elixpo/flappy6502/programmer/README.md

Copied from ~/elixpo_projects/Nano28C64 (MIT, see LICENSE): host CLI (eeprom28c64/),
Arduino firmware (firmware/) and breadboard wiring. Local change: added the `flash`
command (program + verify, then reconnect and verify again). Use ../flash to run it.
