elixpo/flappy6502/GOVERNANCE.md

# Governance

The lead maintainer is @Circuit-Overtime. Material scope, release, governance, and lifecycle changes require maintainer review.

Contributors retain attribution for accepted work. Repository transfer, licensing, security disclosure, publication, and project-status decisions require explicit human approval. Canonical public status is recorded at [elixpo.com](https://elixpo.com).
