elixpo/flappy6502/docs/screenshot.png

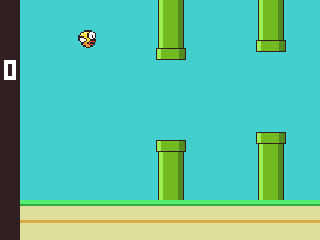
docs/screenshot.png
