elixpo/flappy6502/hardware/flappy6502_schematic.pdf

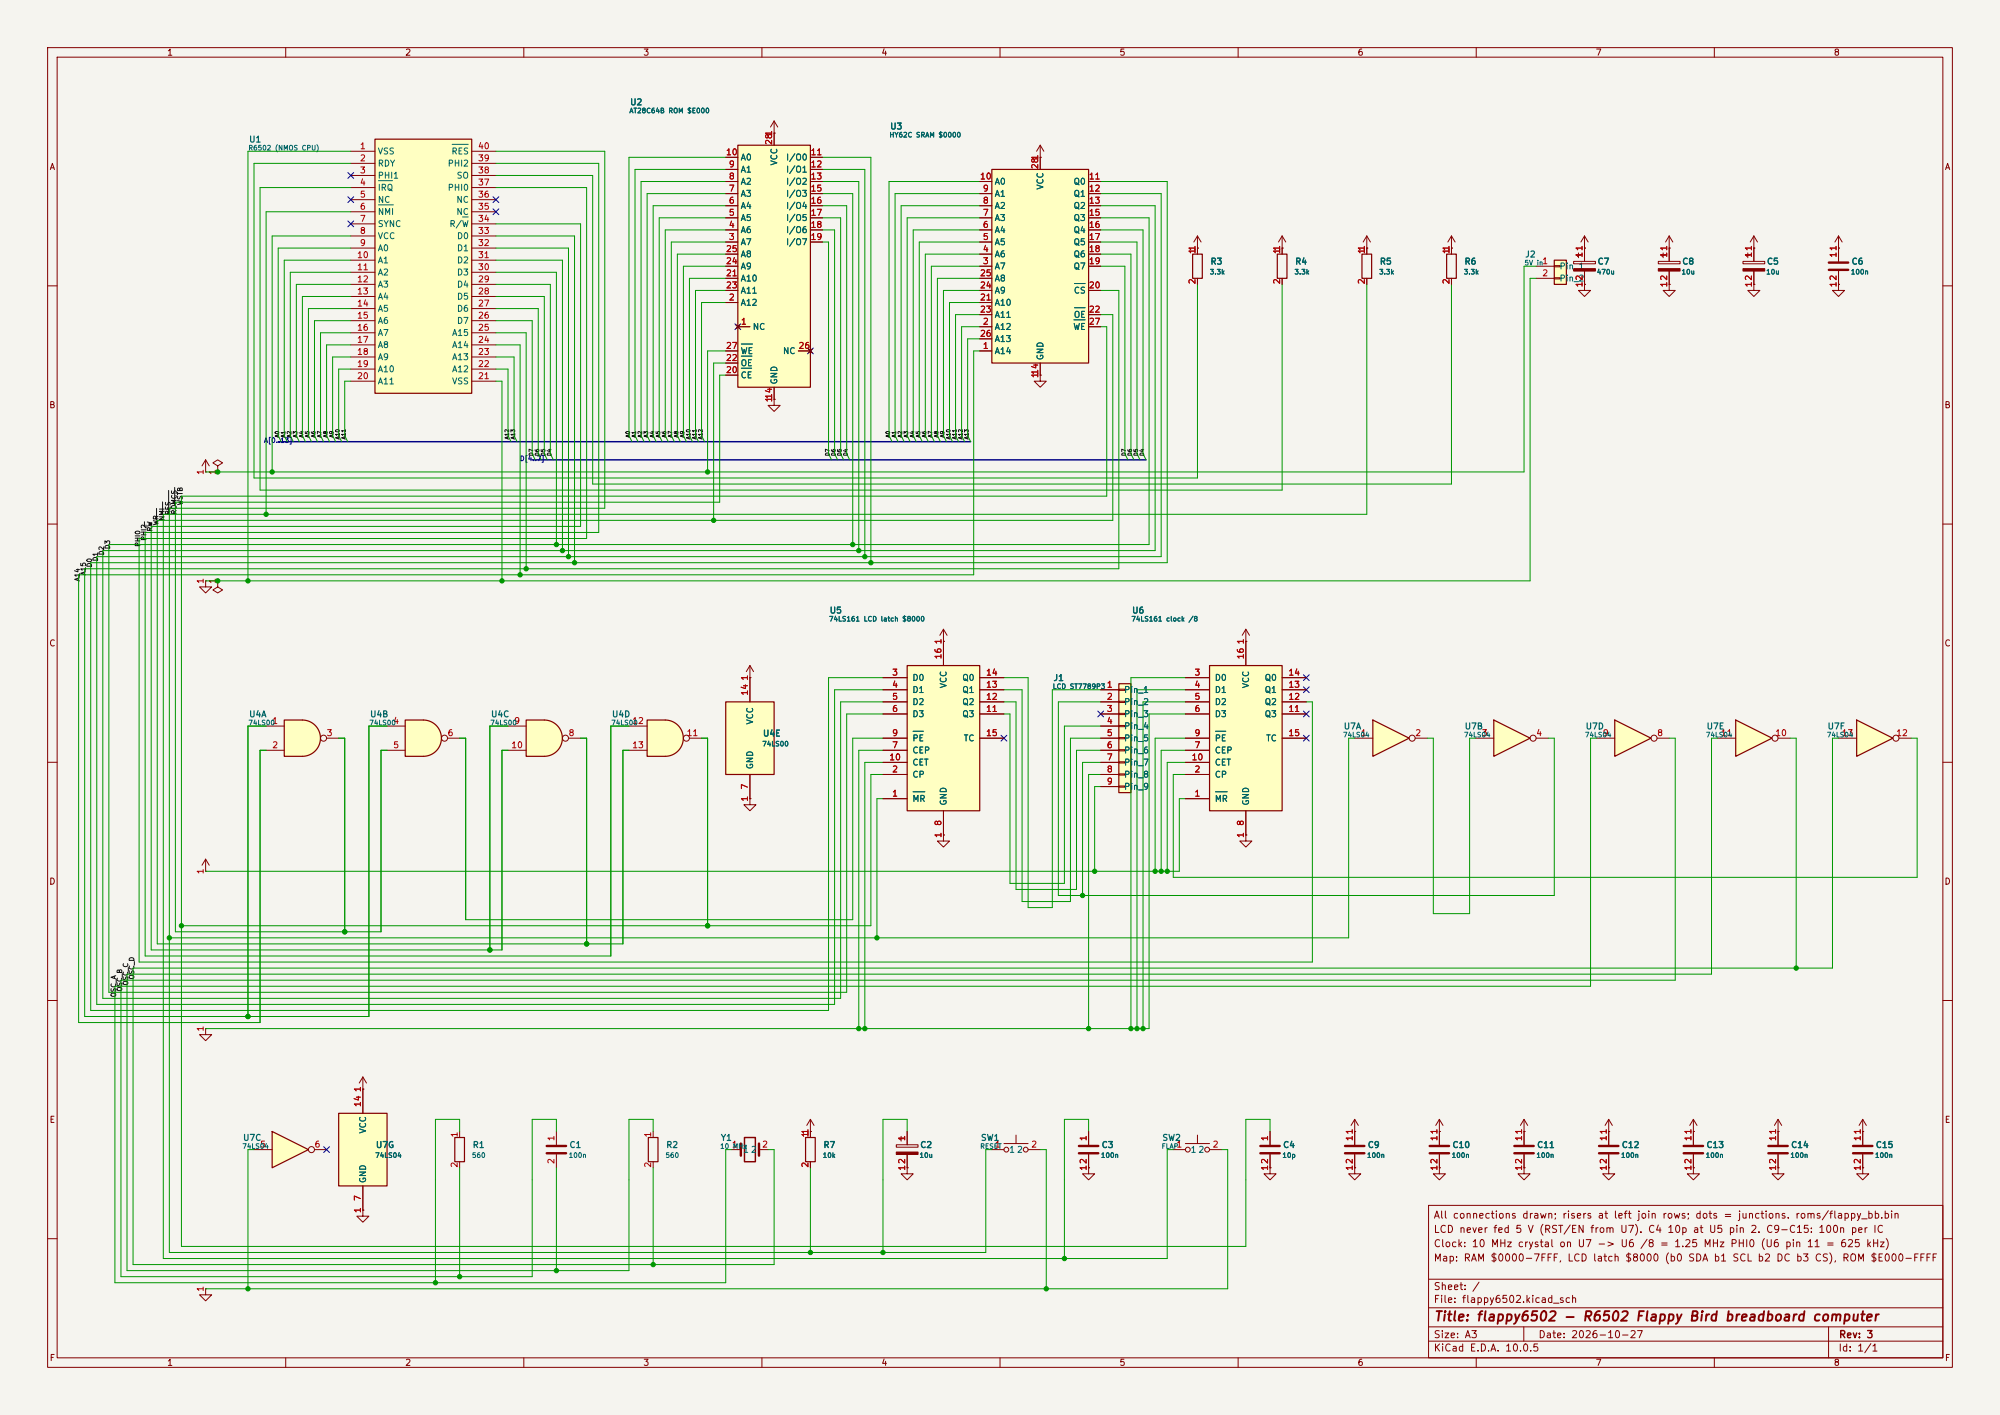
[picture p3: page 1]

All connections drawn; risers at left join rows; dots = junctions. roms/flappy_bb.bin
LCD never fed 5 V (RST/EN from U7). C4 10p at U5 pin 2. C9-C15: 100n per IC
Clock: 10 MHz crystal on U7 -> U6 /8 = 1.25 MHz PHI0 (U6 pin 11 = 625 kHz)
Map: RAM $0000-7FFF, LCD latch $8000 (b0 SDA b1 SCL b2 DC b3 CS), ROM $E000-FFFF

Sheet: /
File: flappy6502.kicad_sch
Title: flappy6502 - R6502 Flappy Bird breadboard computer

Size: A3 | Rev: 3 | F Date: 2026-10-27
KiCad E.D.A. 10.0.5 | Id: 1/1
