elixpo/flappy6502/hardware/flappy6502.kicad_sch

## KiCad design hardware/flappy6502.kicad_sch (2026-10-27)

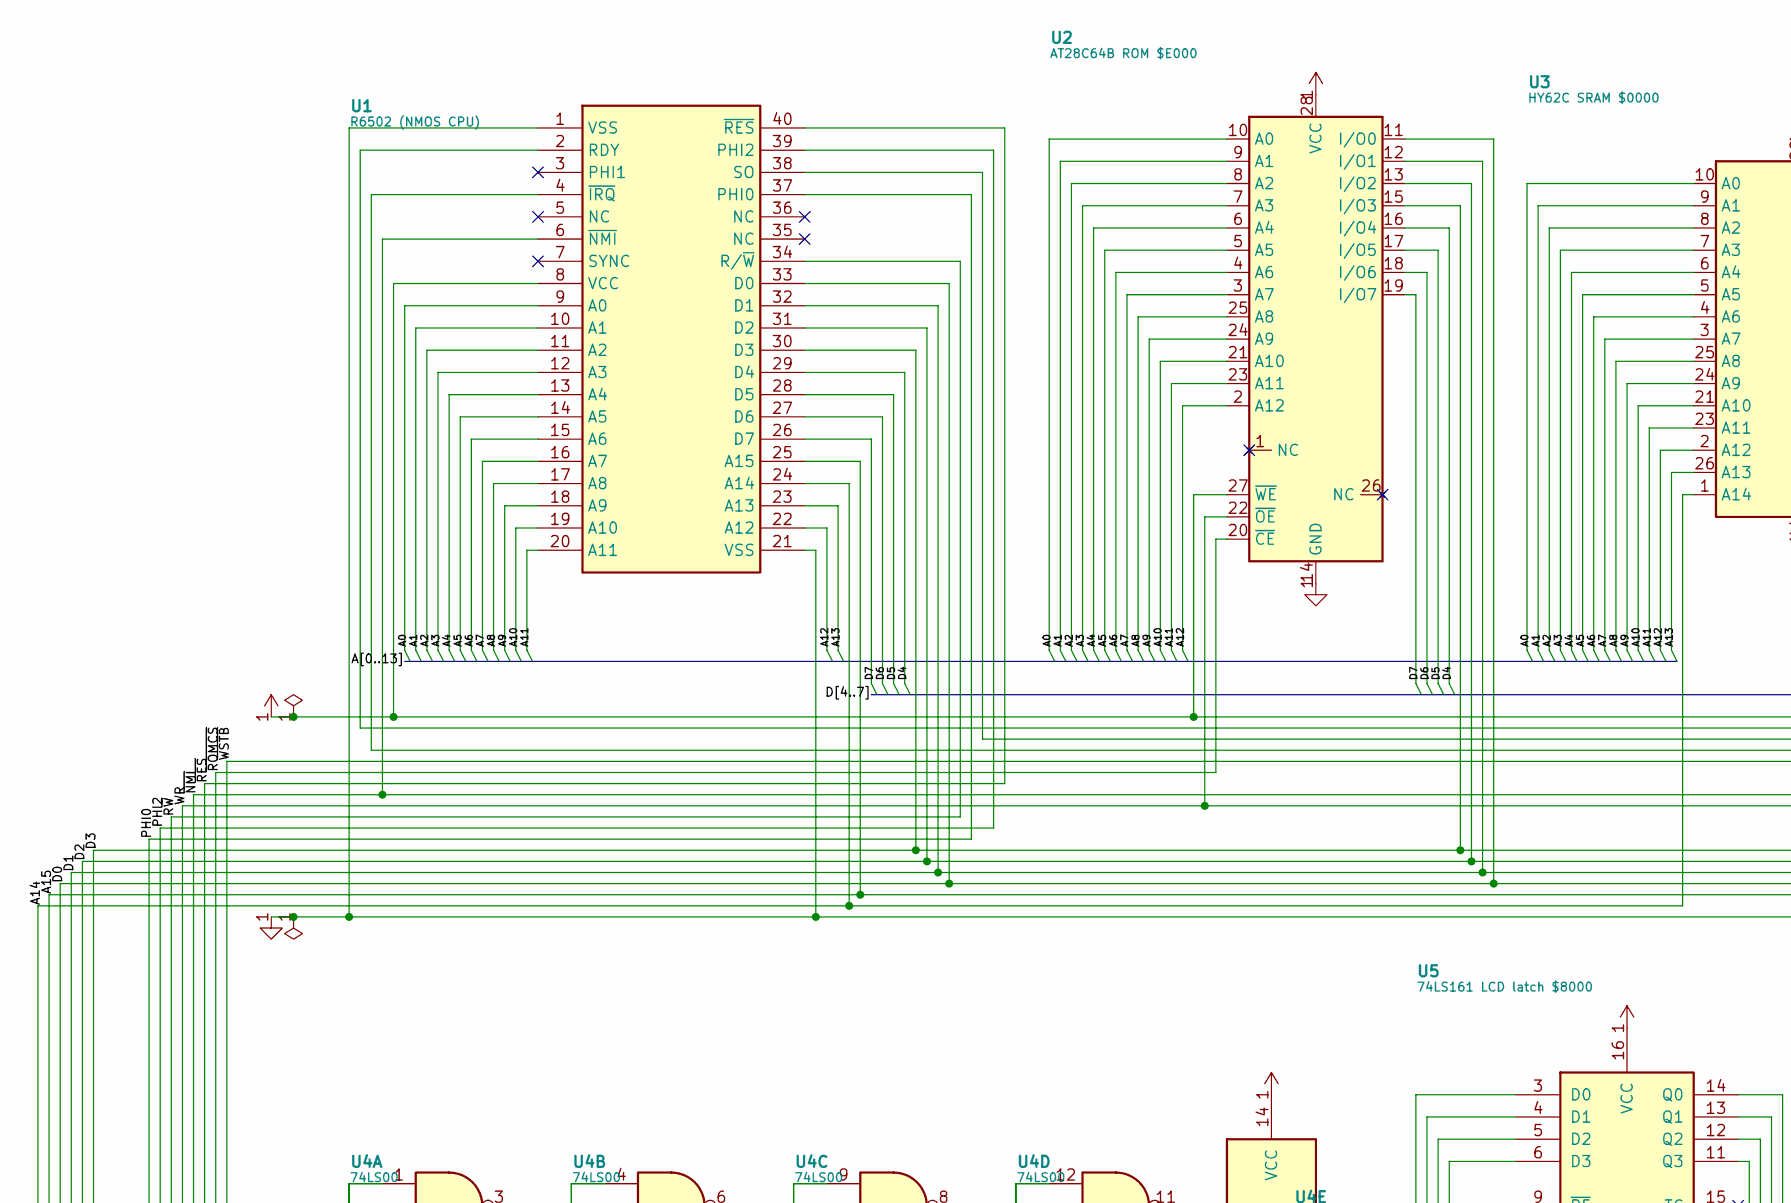
[picture p4: schematic flappy6502.kicad_sch, part in row 1, column 1]

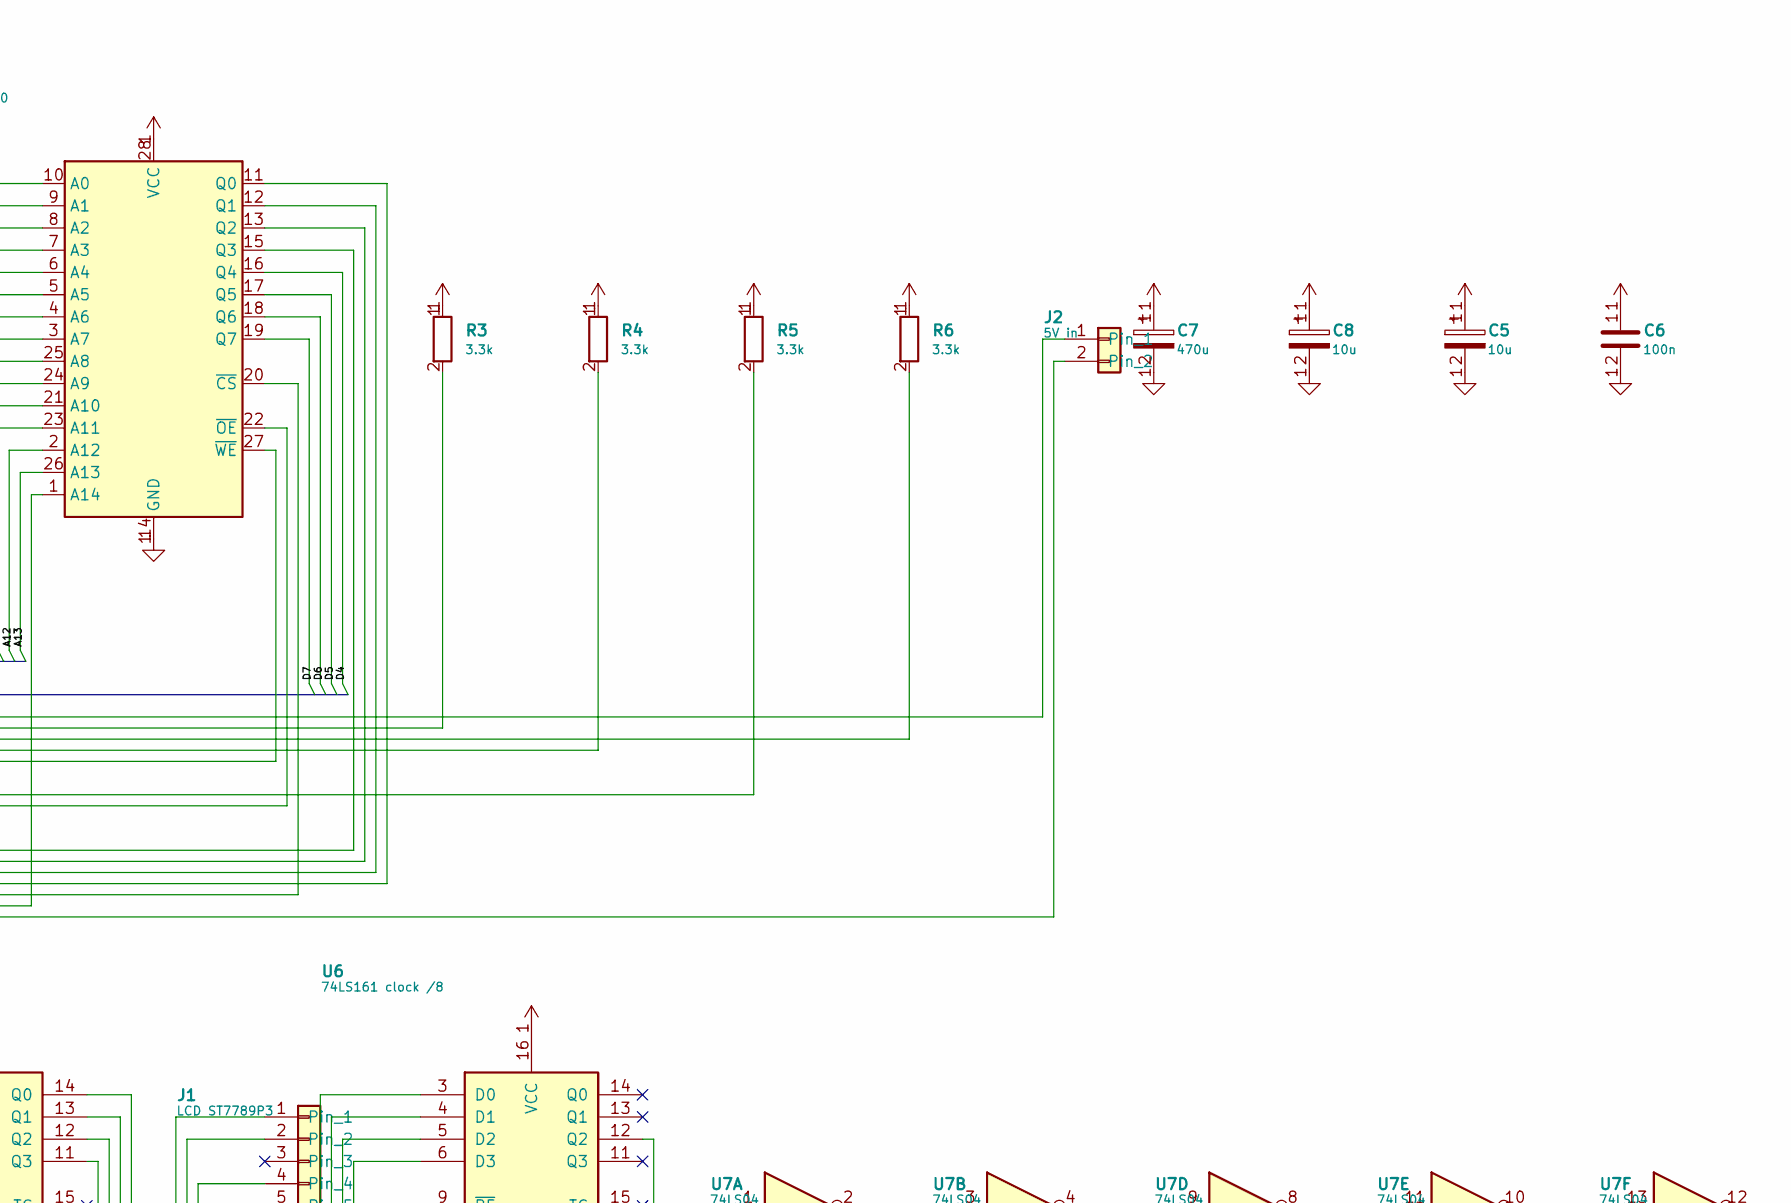
[picture p5: schematic flappy6502.kicad_sch, part in row 1, column 2]

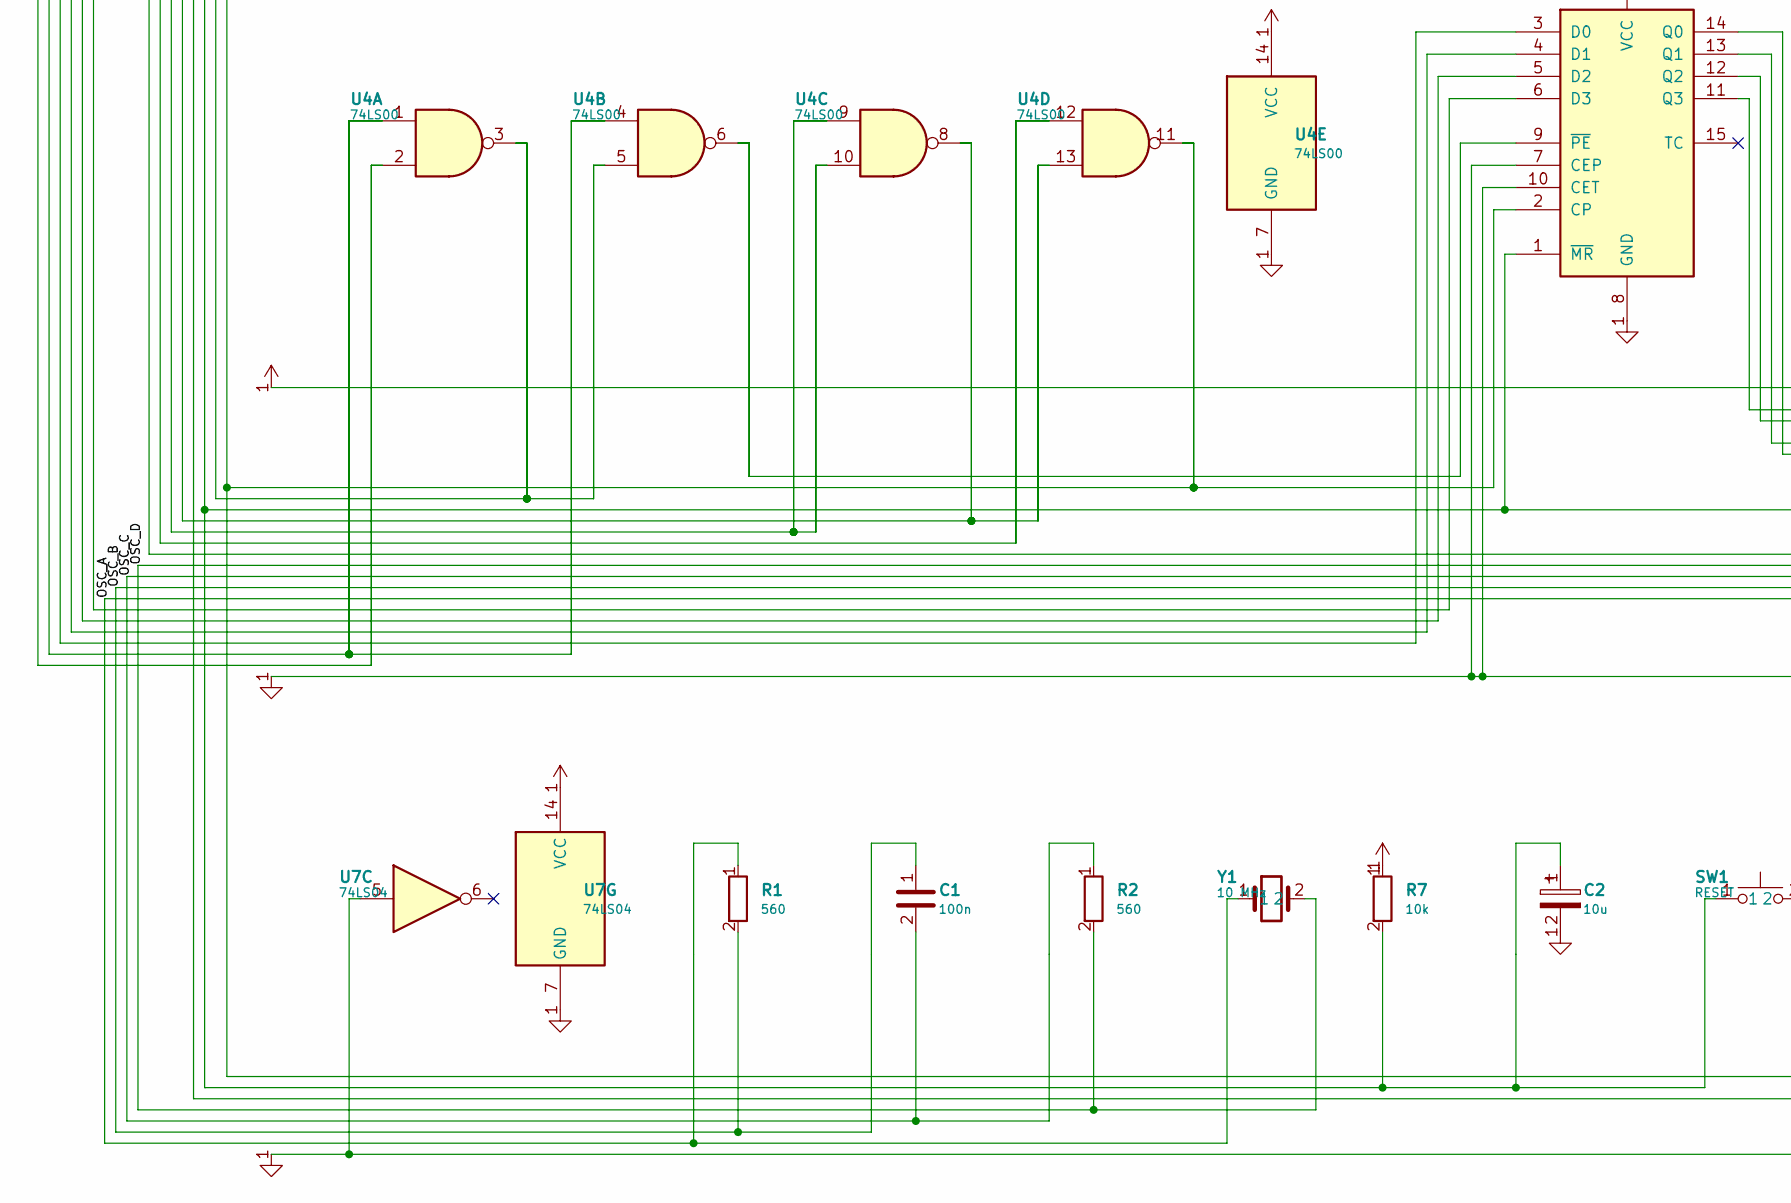
[picture p6: schematic flappy6502.kicad_sch, part in row 2, column 1]

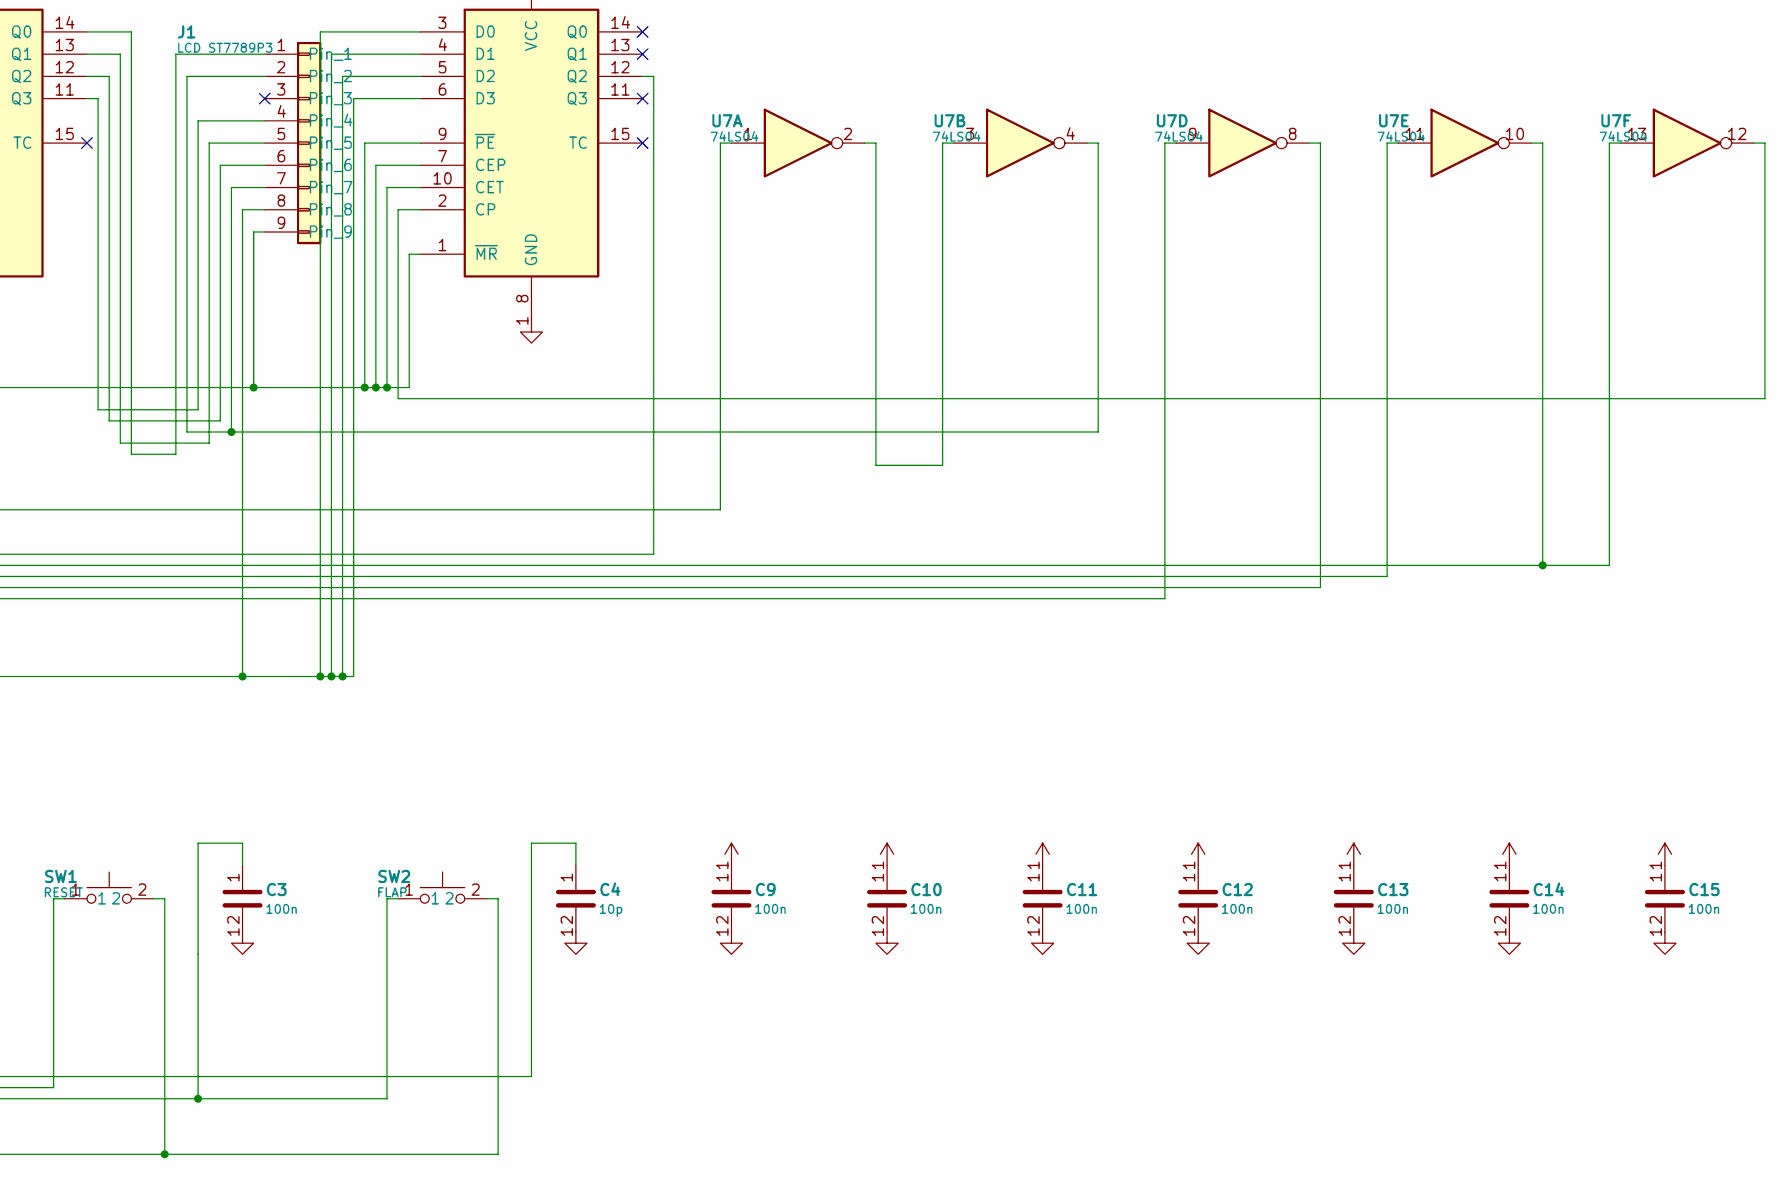
[picture p7: schematic flappy6502.kicad_sch, part in row 2, column 2]

Parts:
C1, C3, C6, C9, C10, C11, C12, C13, C14, C15: 100n
C2, C5, C8: 10u
C4: 10p
C7: 470u
J1: LCD ST7789P3
J2: 5V in
R1, R2: 560
R3, R4, R5, R6: 3.3k
R7: 10k
SW1: RESET
SW2: FLAP
U1: R6502 (NMOS CPU)
U2: AT28C64B ROM $E000
U3: HY62C SRAM $0000
U4: 74LS00
U5: 74LS161 LCD latch $8000
U6: 74LS161 clock /8
U7: 74LS04
Y1: 10 MHz

Connections:
+5V: C5.1, C6.1, C7.1, C8.1, C9.1, C10.1, C11.1, C12.1, C13.1, C14.1, C15.1, J1.9, J2.1, R3.1, R4.1, R5.1, R6.1, R7.1, U1.8 (VCC), U2.27 (~WE), U2.28 (VCC), U3.28 (VCC), U4.14 (VCC), U5.16 (VCC), U6.1 (~MR), U6.7 (CEP), U6.9 (~PE), U6.10 (CET), U6.16 (VCC), U7.14 (VCC)
A0: U1.9 (A0), U2.10 (A0), U3.10 (A0)
A1: U1.10 (A1), U2.9 (A1), U3.9 (A1)
A2: U1.11 (A2), U2.8 (A2), U3.8 (A2)
A3: U1.12 (A3), U2.7 (A3), U3.7 (A3)
A4: U1.13 (A4), U2.6 (A4), U3.6 (A4)
A5: U1.14 (A5), U2.5 (A5), U3.5 (A5)
A6: U1.15 (A6), U2.4 (A6), U3.4 (A6)
A7: U1.16 (A7), U2.3 (A7), U3.3 (A7)
A8: U1.17 (A8), U2.25 (A8), U3.25 (A8)
A9: U1.18 (A9), U2.24 (A9), U3.24 (A9)
A10: U1.19 (A10), U2.21 (A10), U3.21 (A10)
A11: U1.20 (A11), U2.23 (A11), U3.23 (A11)
A12: U1.22 (A12), U2.2 (A12), U3.2 (A12)
A13: U1.23 (A13), U3.26 (A13)
A14: U1.24 (A14), U3.1 (A14), U4.2
A15: U1.25 (A15), U3.20 (~CS), U4.1, U4.4
D0: U1.33 (D0), U2.11 (I/O0), U3.11 (Q0), U5.3 (D0)
D1: U1.32 (D1), U2.12 (I/O1), U3.12 (Q1), U5.4 (D1)
D2: U1.31 (D2), U2.13 (I/O2), U3.13 (Q2), U5.5 (D2)
D3: U1.30 (D3), U2.15 (I/O3), U3.15 (Q3), U5.6 (D3)
D4: U1.29 (D4), U2.16 (I/O4), U3.16 (Q4)
D5: U1.28 (D5), U2.17 (I/O5), U3.17 (Q5)
D6: U1.27 (D6), U2.18 (I/O6), U3.18 (Q6)
D7: U1.26 (D7), U2.19 (I/O7), U3.19 (Q7)
GND: C2.2, C3.2, C4.2, C5.2, C6.2, C7.2, C8.2, C9.2, C10.2, C11.2, C12.2, C13.2, C14.2, C15.2, J1.8, J2.2, SW1.2, SW2.2, U1.1 (VSS), U1.21 (VSS), U2.14 (GND), U3.14 (GND), U4.7 (GND), U5.7 (CEP), U5.8 (GND), U5.10 (CET), U6.3 (D0), U6.4 (D1), U6.5 (D2), U6.6 (D3), U6.8 (GND), U7.5, U7.7 (GND)
unnamed: J1.1, U5.14 (Q0)
unnamed: J1.2, J1.7, U7.4
unnamed: J1.4, U5.11 (Q3)
unnamed: J1.5, U5.13 (Q1)
unnamed: J1.6, U5.12 (Q2)
unnamed: R3.2, U1.2 (RDY)
unnamed: R4.2, U1.4 (~IRQ)
unnamed: R6.2, U1.38 (SO)
unnamed: U4.6, U5.9 (~PE)
unnamed: U6.2 (CP), U7.12
unnamed: U7.2, U7.3
OSC_A: R1.1, U7.9, Y1.1
OSC_B: C1.1, R1.2, U7.8
OSC_C: C1.2, R2.1, U7.11
OSC_D: R2.2, U7.10, U7.13, Y1.2
PHI0: U1.37 (PHI0), U6.12 (Q2)
PHI2: U1.39 (PHI2), U4.12
R~W: U1.34 (R/~W), U4.9, U4.10
WR: U2.22 (~OE), U3.22 (~OE), U4.8, U4.13
~NMI: C3.1, R5.2, SW2.1, U1.6 (~NMI)
~RES: C2.1, R7.2, SW1.1, U1.40 (~RES), U5.1 (~MR), U7.1
~ROMCS: U2.20 (~CE), U4.3, U4.5
~WSTB: C4.1, U3.27 (~WE), U4.11, U5.2 (CP)
