elixpo/flappy6502/(commit log)

2026-10-22 Add ASCII schematic for crystal oscillator and clock divider
2026-10-22 Mark clock circuit as built and verified
2026-10-22 Add R6502P pin connections for NOP test and final system
2026-10-22 Add stage 2 ROM blink test image and wiring
2026-10-22 Add stage 2 continuity checklist
2026-10-22 Add full per-chip pin map for stage 2
2026-10-23 Add SRAM wiring document
2026-10-23 Add ca65 build, RAM test with address-line checks, and 6502 simulator
    [rom.cfg]
2026-10-23 Record RAM test pass and power fixes
2026-10-23 Add ST7789 LCD bring-up test, SPI decoding in simulator, LCD wiring
2026-10-23 Landscape LCD driver, 12x12 bird sprite and palette, graphics test, framebuffer rendering in simulator, 1.25 MHz clock
2026-10-23 Bird scaled to 18x18 (1.5x); button wiring for NMI
2026-10-23 Plan: hardware SPI shifter (74LS165 + 74LS161) at $A000
2026-10-23 Flappy v2: auto-clock SPI wiring, compiled bird, fixed HUD score, faster pipes and physics
2026-10-23 Stage 7 wiring with a single 74LS00 plus two spare U9 inverters; fix lcd2 init loop
2026-10-23 Add stage-7 SPI diagnostic (three squares, three send methods)
2026-10-25 Document the wires between the two breadboards
2026-10-25 Flappy v2 bit-bang build for the proven wiring (SCL from latch pin 13), own physics; fix Makefile include deps
2026-10-26 lcd2: ESP32-identical init sequence and per-command CS frames (bit-bang); fix init loop flag bug
2026-10-26 Final LCD wiring: no 5 V into the module, inputs low at power-up (RST/EN from 74LS04 after /RES)
2026-10-27 Add KiCad schematic of the full working build (generated, ERC clean) and PDF export
    [flappy6502.kicad_sch]
2026-10-27 Schematic: one A3 sheet with every connection wired (rows + channels, risers, A/D buses), netlist-verified
    [flappy6502.kicad_sch]
2026-11-01 flappy512: complete Flappy Bird in 512 bytes of 6502 code (linker-enforced), simulator checks
    [rom512.cfg]
2026-11-01 flappy1k: colour Flappy Bird in 1 KiB (sprite bird, digit score, shaded pipes, scrolling ground), linker-enforced, simulator checks
    [rom1k.cfg]
2026-11-06 hardware/connections.txt: every connection of the working build, stage by stage, per chip and pin
2026-11-06 connections.txt: clock stage by pin (8-13 oscillator, 1-6 reset buffer), crystal and RC parts leg by leg
2026-11-06 connections.txt: oscillator as built (crystal on 74LS04 pins 13 and 9, 10-9 jumper, pin 8 to divider)
